neta79/gizmo_card/README.md

GizmoCard is my business card. 

It is also a gadget that runs Python:

- fully programmable;
- with Wi-Fi and BLE support;
- an USB port to plug it into a computer and do things with it;
- and a catchy matrix display for good measure.
