neta79/gizmo_card/hardware/project/gizmo_card.kicad_pcb

## KiCad design hardware/project/gizmo_card.kicad_pcb (2023-12-24)

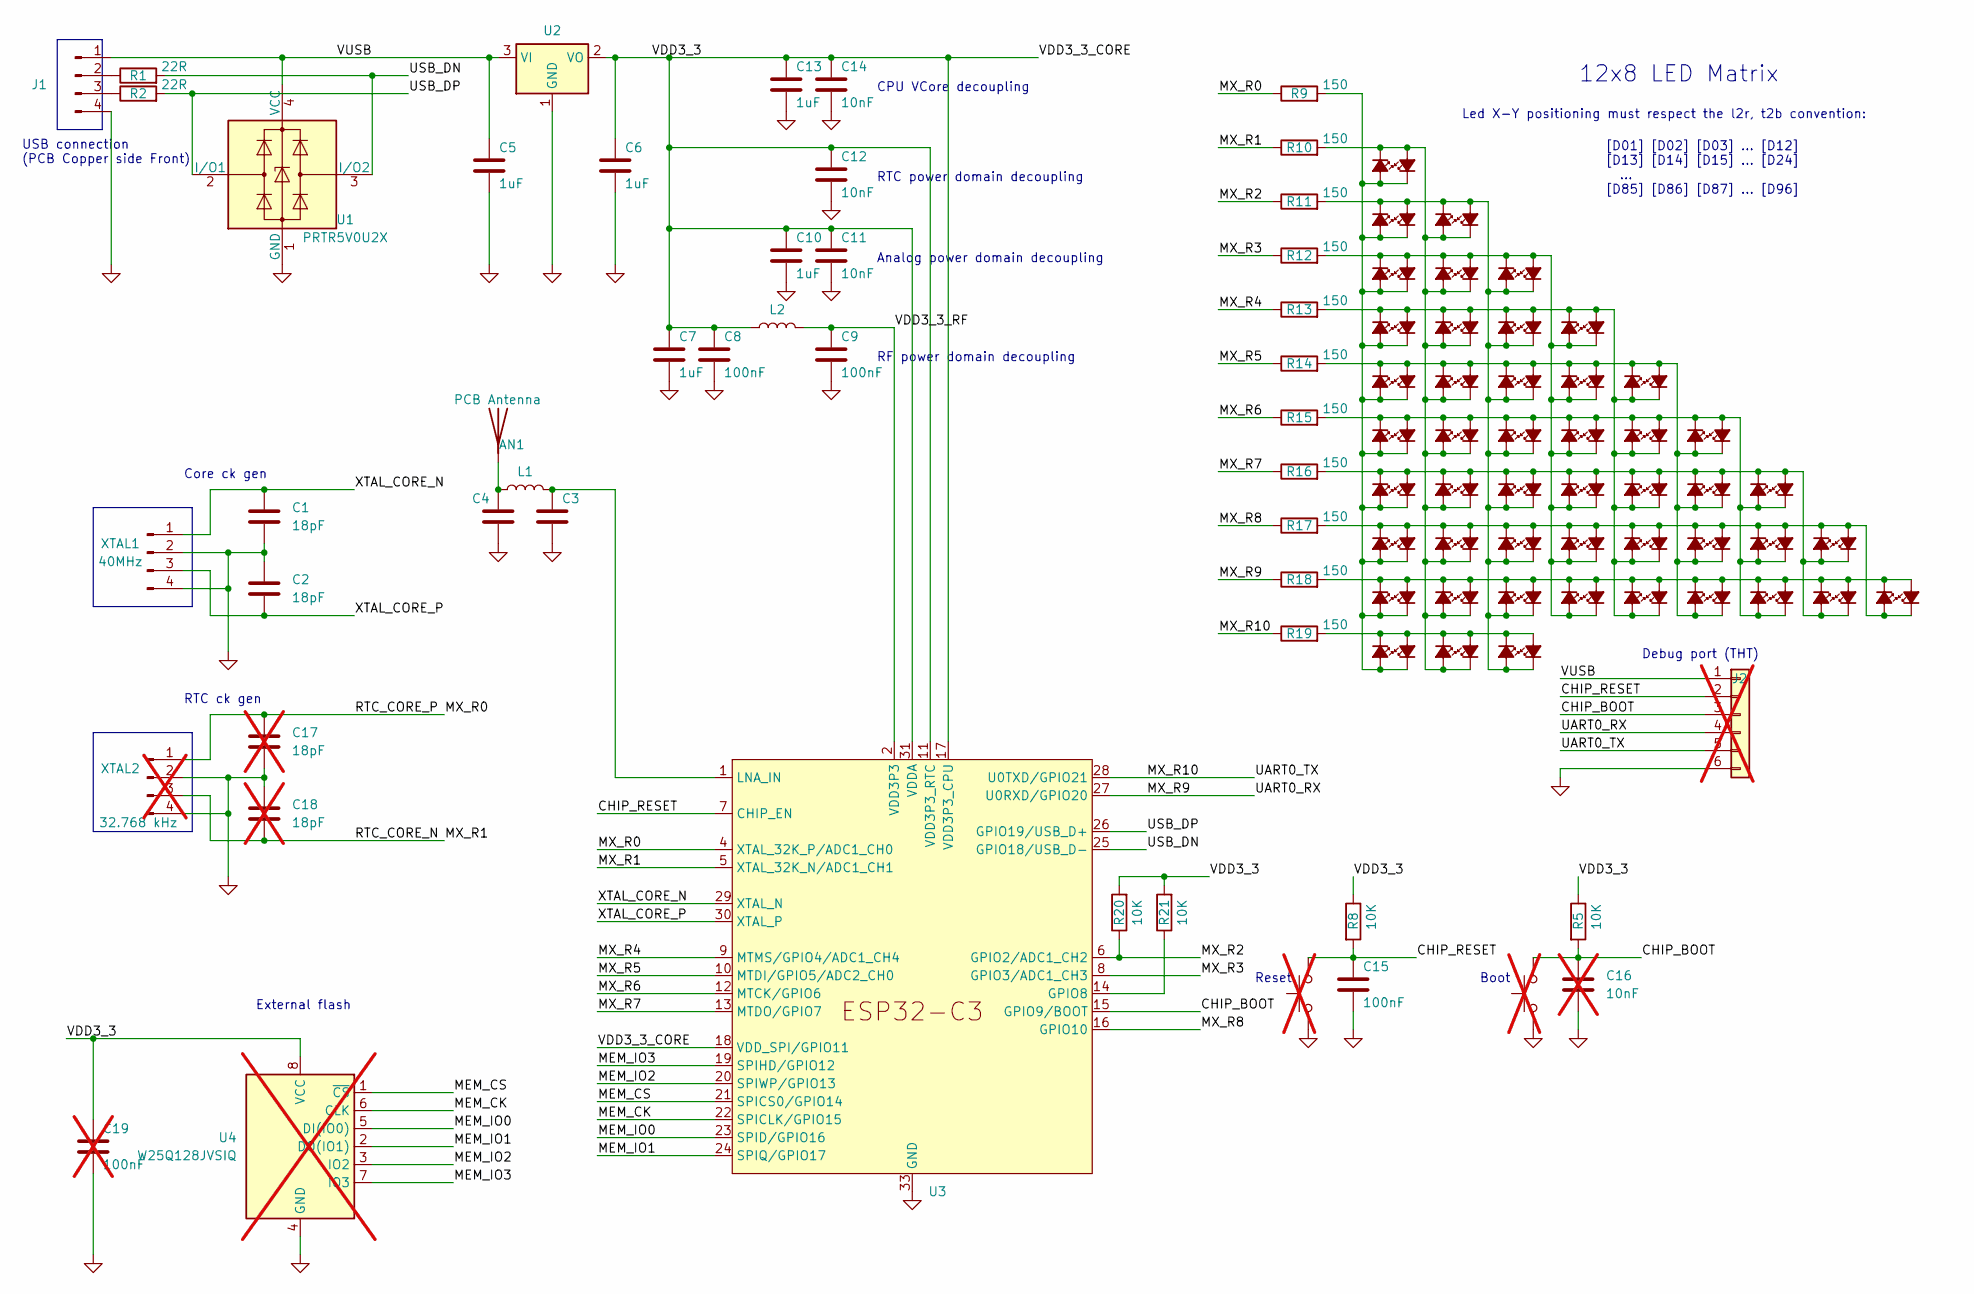
[picture p1: schematic gizmo_card.kicad_sch, Coolbiz: Business card / cool gadget thing]

Parts:
AN1: PCB Antenna; Texas_SWRA117D_2.4GHz_Right
C1, C2: 18pF; C_0402_1005Metric; LCSC Part C106202
C3, C4: TBD; C_0402_1005Metric
C5, C6, C7, C10, C13: 1uF; C_0402_1005Metric; LCSC Part C29266
C8, C9, C15: 100nF; C_0402_1005Metric; LCSC Part C60474
C11, C12, C14: 10nF; C_0402_1005Metric; LCSC Part C60133
C16: 10nF; C_0402_1005Metric; LCSC Part C60133; not fitted
C17, C18: 18pF; C_0402_1005Metric; LCSC Part C106202; not fitted
C19: 100nF; C_0402_1005Metric; LCSC Part C60474; not fitted
D1, D2, D3, D4, D5, D6, D7, D8, D9, D10, D11, D12, D13, D14, D15, D16, D17, D18, D19, D20, D21, D22, D23, D24, D25, D26, D27, D28, D29, D30, D31, D32, D33, D34, D35, D36, D37, D38, D39, D40, D41, D42, D43, D44, D45, D46, D47, D48, D49, D50, D51, D52, D53, D54, D55, D56, D57, D58, D59, D60, D61, D62, D63, D64, D65, D66, D67, D68, D69, D70, D71, D72, D73, D74, D75, D76, D77, D78, D79, D80, D81, D82, D83, D84, D85, D86, D87, D88, D89, D90, D91, D92, D93, D94, D95, D96: LED XL-1005SURC; LED_0402_1005Metric; LCSC Part C965790
J1: XL-1005SURC; PCB_USB_A_Male_Plug
J2: Conn_01x03; PinHeader_1x06_P2.54mm_Vertical; not fitted
L1: TBD; L_0402_1005Metric
L2: 2nH 500mA; L_0402_1005Metric; LCSC Part C2991862
R1, R2: 22R; R_0402_1005Metric; LCSC Part C114765
R5, R8, R20, R21: 10K; R_0402_1005Metric; LCSC Part C60490
R9, R10, R11, R12, R13, R14, R15, R16, R17, R18, R19: 150; R_0402_1005Metric; LCSC Part C138054
SW1, SW2: SW_Push; SW_Push_1P1T_NO_6x6mm_H9.5mm; not fitted
U1: PRTR5V0U2X; SOT-143; LCSC Part C5158049
U2: H7233-1; SOT-23-3; LCSC Part C277859
U3: ESP32-C3FN4; QFN-32-1EP_5x5mm_P0.5mm_EP3.45x3.45mm; LCSC Part C5143572
U4: W25Q128JVSIQ; SOIC-8_5.23x5.23mm_P1.27mm; LCSC Part C97521; not fitted
XTAL1: 40MHz; Oscillator_SMD_EuroQuartz_XO32-4Pin_3.2x2.5mm; Part CF4040M00010001; LCSC Part C7294598
XTAL2: 32.768 kHz; Oscillator_SMD_EuroQuartz_XO32-4Pin_3.2x2.5mm; Part DF2032K76812001; LCSC Part C7294751; not fitted

Connections:
/CHIP_BOOT: C16.1, J2.3, R5.2, SW2.2, U3.15 (GPIO9/BOOT)
/CHIP_RESET: C15.1, J2.2, R8.2, SW1.2, U3.7 (CHIP_EN)
/MEM_CK: U3.22 (SPICLK/GPIO15), U4.6 (CLK)
/MEM_CS: U3.21 (SPICS0/GPIO14), U4.1 (~CS)
/MEM_IO0: U3.23 (SPID/GPIO16), U4.5 (DI(IO0))
/MEM_IO1: U3.24 (SPIQ/GPIO17), U4.2 (DO(IO1))
/MEM_IO2: U3.20 (SPIWP/GPIO13), U4.3 (IO2)
/MEM_IO3: U3.19 (SPIHD/GPIO12), U4.7 (IO3)
/MX_R0: C17.1, R9.1, U3.4 (XTAL_32K_P/ADC1_CH0), XTAL2.1
/MX_R1: C18.2, R10.1, U3.5 (XTAL_32K_N/ADC1_CH1), XTAL2.3
/MX_R2: R11.1, R20.1, U3.6 (GPIO2/ADC1_CH2)
/MX_R3: R12.1, U3.8 (GPIO3/ADC1_CH3)
/MX_R4: R13.1, U3.9 (MTMS/GPIO4/ADC1_CH4)
/MX_R5: R14.1, U3.10 (MTDI/GPIO5/ADC2_CH0)
/MX_R6: R15.1, U3.12 (MTCK/GPIO6)
/MX_R7: R16.1, U3.13 (MTDO/GPIO7)
/MX_R8: R17.1, U3.16 (GPIO10)
/MX_R9: J2.4, R18.1, U3.27 (U0RXD/GPIO20)
/MX_R10: J2.5, R19.1, U3.28 (U0TXD/GPIO21)
/USB_DN: R1.2, U1.3 (I/O2), U3.25 (GPIO18/USB_D-)
/USB_DP: R2.2, U1.2 (I/O1), U3.26 (GPIO19/USB_D+)
/VDD3_3: C6.1, C7.1, C8.1, C10.1, C11.1, C12.1, C13.1, C14.1, C19.1, L2.1, R5.1, R8.1, R20.2, R21.2, U2.2 (VO), U3.11 (VDD3P3_RTC), U3.17 (VDD3P3_CPU), U3.18 (VDD_SPI/GPIO11), U3.31 (VDDA), U3.32 (VDDA), U4.8 (VCC)
/VDD3_3_RF: C9.1, L2.2, U3.2 (VDD3P3), U3.3 (VDD3P3)
/VUSB: C5.1, J1.1, J2.1, U1.4 (VCC), U2.3 (VI)
/XTAL_CORE_N: C1.1, U3.29 (XTAL_N), XTAL1.1
/XTAL_CORE_P: C2.2, U3.30 (XTAL_P), XTAL1.3
GND: C1.2, C2.1, C3.2, C4.2, C5.2, C6.2, C7.2, C8.2, C9.2, C10.2, C11.2, C12.2, C13.2, C14.2, C15.2, C16.2, C17.2, C18.1, C19.2, J1.4, J2.6, SW1.1, SW2.1, U1.1 (GND), U2.1 (GND), U3.33 (GND), U4.4 (GND), XTAL1.2, XTAL1.4, XTAL2.2, XTAL2.4
unnamed: AN1.1 (A), C4.1, L1.1
unnamed: D1.2 (A), D2.1 (K), D3.2 (A), D4.1 (K), D7.2 (A), D8.1 (K), D13.2 (A), D14.1 (K), D21.2 (A), D22.1 (K), D31.2 (A), D32.1 (K), D43.2 (A), D44.1 (K), D57.2 (A), D58.1 (K), D73.2 (A), D74.1 (K), D91.2 (A), D92.1 (K), R9.2
unnamed: D1.1 (K), D2.2 (A), D5.2 (A), D6.1 (K), D9.2 (A), D10.1 (K), D15.2 (A), D16.1 (K), D23.2 (A), D24.1 (K), D33.2 (A), D34.1 (K), D45.2 (A), D46.1 (K), D59.2 (A), D60.1 (K), D75.2 (A), D76.1 (K), D93.2 (A), D94.1 (K), R10.2
unnamed: D7.1 (K), D8.2 (A), D9.1 (K), D10.2 (A), D11.1 (K), D12.2 (A), D19.2 (A), D20.1 (K), D27.2 (A), D28.1 (K), D37.2 (A), D38.1 (K), D49.2 (A), D50.1 (K), D63.2 (A), D64.1 (K), D79.2 (A), D80.1 (K), R12.2
unnamed: D3.1 (K), D4.2 (A), D5.1 (K), D6.2 (A), D11.2 (A), D12.1 (K), D17.2 (A), D18.1 (K), D25.2 (A), D26.1 (K), D35.2 (A), D36.1 (K), D47.2 (A), D48.1 (K), D61.2 (A), D62.1 (K), D77.2 (A), D78.1 (K), D95.2 (A), D96.1 (K), R11.2
unnamed: D13.1 (K), D14.2 (A), D15.1 (K), D16.2 (A), D17.1 (K), D18.2 (A), D19.1 (K), D20.2 (A), D29.2 (A), D30.1 (K), D39.2 (A), D40.1 (K), D51.2 (A), D52.1 (K), D65.2 (A), D66.1 (K), D81.2 (A), D82.1 (K), R13.2
unnamed: D21.1 (K), D22.2 (A), D23.1 (K), D24.2 (A), D25.1 (K), D26.2 (A), D27.1 (K), D28.2 (A), D29.1 (K), D30.2 (A), D41.2 (A), D42.1 (K), D53.2 (A), D54.1 (K), D67.2 (A), D68.1 (K), D83.2 (A), D84.1 (K), R14.2
unnamed: D31.1 (K), D32.2 (A), D33.1 (K), D34.2 (A), D35.1 (K), D36.2 (A), D37.1 (K), D38.2 (A), D39.1 (K), D40.2 (A), D41.1 (K), D42.2 (A), D55.2 (A), D56.1 (K), D69.2 (A), D70.1 (K), D85.2 (A), D86.1 (K), R15.2
unnamed: D43.1 (K), D44.2 (A), D45.1 (K), D46.2 (A), D47.1 (K), D48.2 (A), D49.1 (K), D50.2 (A), D51.1 (K), D52.2 (A), D53.1 (K), D54.2 (A), D55.1 (K), D56.2 (A), D71.2 (A), D72.1 (K), D87.2 (A), D88.1 (K), R16.2
unnamed: D57.1 (K), D58.2 (A), D59.1 (K), D60.2 (A), D61.1 (K), D62.2 (A), D63.1 (K), D64.2 (A), D65.1 (K), D66.2 (A), D67.1 (K), D68.2 (A), D69.1 (K), D70.2 (A), D71.1 (K), D72.2 (A), D89.2 (A), D90.1 (K), R17.2
unnamed: D73.1 (K), D74.2 (A), D75.1 (K), D76.2 (A), D77.1 (K), D78.2 (A), D79.1 (K), D80.2 (A), D81.1 (K), D82.2 (A), D83.1 (K), D84.2 (A), D85.1 (K), D86.2 (A), D87.1 (K), D88.2 (A), D89.1 (K), D90.2 (A), R18.2
unnamed: D91.1 (K), D92.2 (A), D93.1 (K), D94.2 (A), D95.1 (K), D96.2 (A), R19.2
unnamed: J1.2, R1.1
unnamed: J1.3, R2.1
unnamed: R21.1, U3.14 (GPIO8)
unnamed: C3.1, L1.2, U3.1 (LNA_IN)

Notes on the sheet:
[D01] [D02] [D03] ... [D12] [D13] [D14] [D15] ... [D24] ... [D85] [D86] [D87] ... [D96]
Debug port (THT)
RF power domain decoupling
Boot
Core ck gen
External flash
Led X-Y positioning must respect the l2r, t2b convention:
12x8 LED Matrix
Analog power domain decoupling
RTC ck gen
CPU VCore decoupling
USB connection (PCB Copper side Front)
RTC power domain decoupling
Reset

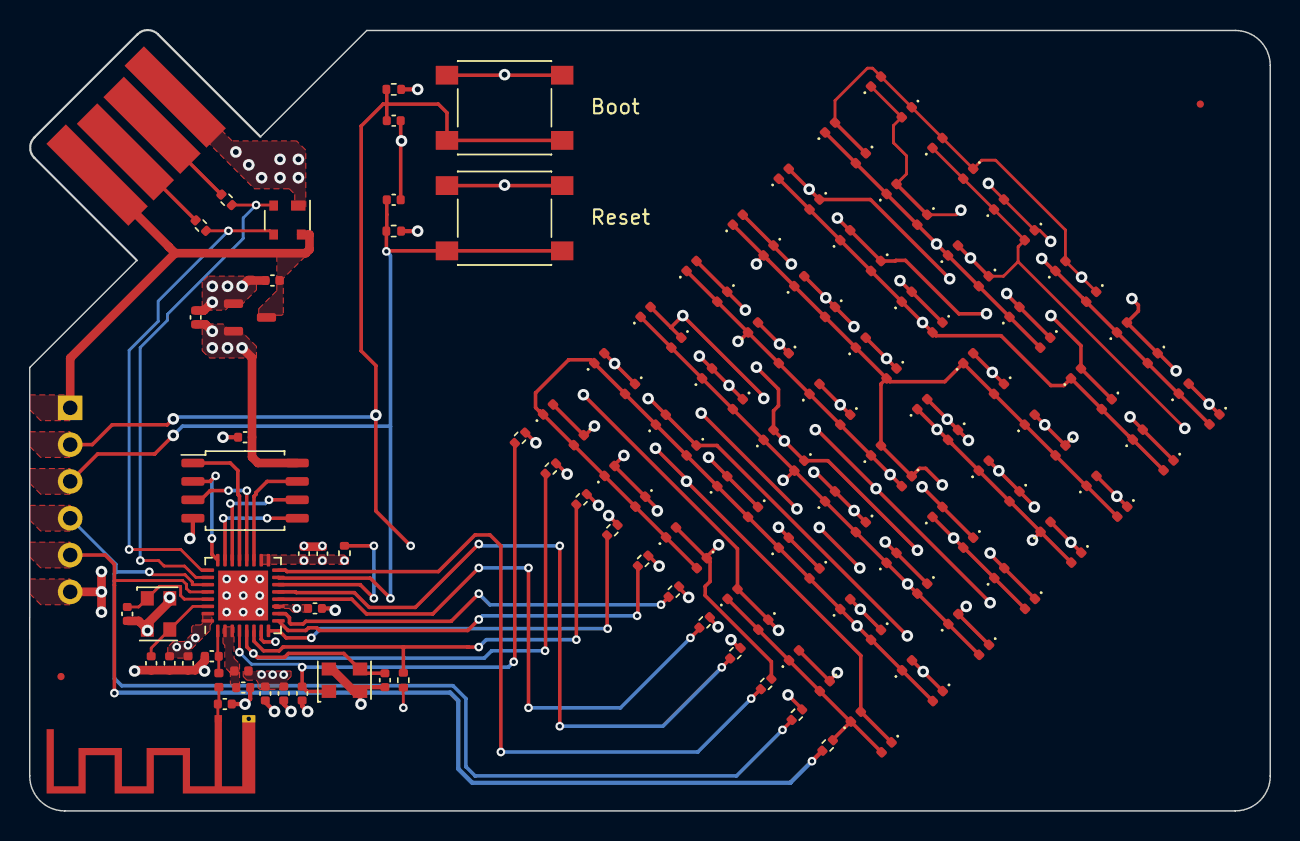
[picture p2: board gizmo_card.kicad_pcb from above]

Board: 4 copper layers, 85.6 x 53.9 mm, 147 parts (0 on the bottom side), 43 nets.

Other parts of the board:
REF1, REF2: Fiducial_0.5mm_Mask1mm
