neta79/gizmo_card/(threads)

Thread 1 (2023-12-12):

AMS1117-3.3 LDO regulator is too bulky

neta79, 2023-12-12:
The voltage reg in a SOT-89 package stands out a little too much.
The power supply real estate area is not too crowded, maybe it's worth to replace the high-current AMS1117-3.3 one smaller, lower-spect LDO in a smaller package.

It's technically not ideal, however Espressif themselves did this with the ESP32­C3­MINI­1 module. So it can be done I guess.

neta79, 2023-12-12:
Another idea (though not really worth persuing) is 2 parallel small-spec LDO regs with series balance resistors. There's plenty of available real estate in the power supply section of the board to attempt that.

neta79, 2023-12-14:
I'm testing H7233-1 which is a SOT-23-3 package. I'm keen to upgrading to a SOT-23-5 LDO. Those are much more available and withstand a little more power dissipation.
H7233-1 or analogues aren't really distributed outside of China suppliers, it's a lock-in device.

Thread 3 (2023-12-12):

Back-side tented or filled vias

neta79, 2023-12-12:
In order to preserve the back side script, vias should be tented.
This should allow the fab to successfully lay the silkscreen print over them.

Unfortunately Kicad is mostly a pain with this; it may require a post-processing pass on the gerber files.
Also fabs that honor this requirement tend to err on the expensive side unfortunately.

Closed 2023-12-12.

Thread 4 (2023-12-12):

change push button footprints

neta79, 2023-12-12:
Change the push button footprints. By default they are DNP, however they must match precisely some massively produced pushbutton component, easy to identify and source. In case I don't have them in my bins.

Closed 2023-12-12.
