neta79/gizmo_card/(commit log)

2023-12-11 inital schematic and PCB design
    [bizcool_card.kicad_pcb, bizcool_card.kicad_sch]
2023-12-11 asset rename
    [bizcool_card.kicad_pcb, bizcool_card.kicad_sch]
2023-12-11 move debug header out of the way
    [bizcool_card.kicad_pcb]
2023-12-12 changed: script on the back face
    [bizcool_card.kicad_pcb]
2023-12-12 fix: correct LDO component part name
    [bizcool_card.kicad_sch]
2023-12-12 buried all vias that don't belong to a pad
    hopefully this closes #3
    [bizcool_card.kicad_pcb]
2023-12-12 fix: LCSC component references
    [bizcool_card.kicad_pcb, bizcool_card.kicad_sch]
2023-12-12 fix disconnected cut outline, change push button footprints
    - Edge.Cuts layer was not a properly closed shape
    - adopted quite bulky 6x6 SMT push buttons (still DNP though)
    [bizcool_card.kicad_pcb, bizcool_card.kicad_sch]
2023-12-12 fix: border connector solder mask, GND trace
    [bizcool_card.kicad_pcb]
2023-12-12 change LDO regulator
    switched to a SOT-23-3 LDO reg, a smaller one (400mA).
    technically not in-spec, should use 2 of these.
    [bizcool_card.kicad_pcb, bizcool_card.kicad_sch]
2023-12-14 design sent for a test print
    [bizcool_card.kicad_pcb]
2023-12-24 fix: d1-d6 reordering, re-routing
    [bizcool_card.kicad_pcb, bizcool_card.kicad_sch]
2024-04-20 layout update
    [gizmo_card.kicad_pcb, gizmo_card.kicad_sch]
